SyrNitram/BLDC_Controller/3-DOCUMENTS/2-Conception/Fonctionnalités.docx

# Liste des fonctionnalités

## Pilotage du moteur

1. Pilotage des Mosfets
  a. Gestion des temps morts
  b. Gestion du courant des grilles
2. Fonctionnement 6-step
  a. Lecture des capteurs à effets Hall
  b. Mise à jour de la position du moteur
  c. Changement d’état des Mosfets
3. Asservissement de la vitesse
  a. Mesure de la vitesse
  b. Asservissement
4. Limitation du courant dans le moteur
  a. Mesure du courant
  b. Amplification du signal
  c. Filtrage
  d. Echantillonnage
  e. Asservissement
5. Asservissement de la tension
  a. Asservissement

## Communication

1. Réception de commande
  a. Décodage de la commande
  b. Mise à jour des paramètres
2. Envoie d’information sur l’état
  a. Récupération des données
  b. Génération de la trame
  c. Envoi de la trame

# Solutions techniques

## Contrôle du moteur

### Asservissement de la vitesse

Fonction à réaliser | Solution technique
Mesure de vitesse | Enregistrement de la valeur d’un compteur remis à zéro à chaque changement d’état des capteurs à effets halls
Asservissement | Calcul de la tension ciblée en fonction de la vitesse actuelle et de la vitesse de commande

### Limitation du courant

Fonction à réaliser | Solution technique
Mesure du courant | Resistance série de très faible valeur et mesure la tension à ses bornes
Amplification du signal | Amplificateur différentiel (gain à définir)
Echantillonnage | Mesure ADC à intervalles régulier
Filtrage | Filtre passe-bas (moyenneur) numérique
Asservissement | Ajustement de la valeur de tension de sortie en fonction courant maximum autorisé, du courant mesuré et de la tension ciblée

### Asservissement de la tension

Fonction à réaliser | Solution technique
Asservissement | Ajustement du rapport cyclique et du sens de rotation en fonction de la valeur de tension de sortie

Figure 1 Fonctionnement de l'asservissement en vitesse

### Pilotage des Mosfets

Fonction à réaliser | Solution technique
Gestion des temps morts | Composant intégré avec temps morts réglables
Gestion du courant des grilles | Composant intégré avec courant de contrôle des grilles réglables

### Fonctionnement 6-step

Fonction à réaliser | Solution technique
Lecture des capteurs à effets Hall | Interruption déclenchée sur changement d’état de chaque capteur
Mise à jour de la position du moteur | Incrément ou décrément d’une variable selon l’état actuel des capteurs et l’état précédent
Changement d’état des Mosfets | Table de vérité associant l’état des capteurs à effet Hall et l’état de commutation de Mosfets

# Communication

A voir en fonction du système dans lequel sera intégré la carte.
