SyrNitram/BLDC_Controller/3-DOCUMENTS/1-Gestion_projet/Synoptique.jpeg

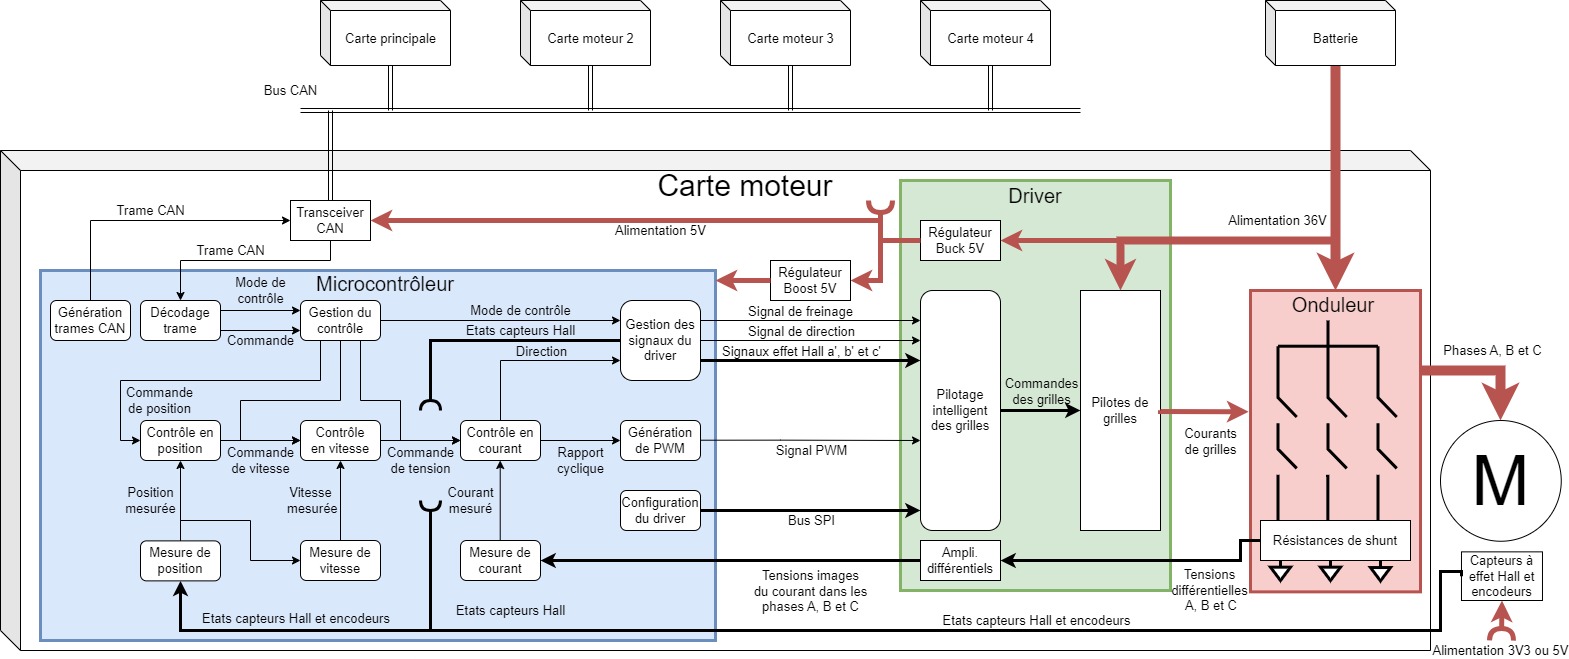
3-DOCUMENTS/1-Gestion_projet/Synoptique.jpeg
