SyrNitram/BLDC_Controller/3-DOCUMENTS/1-Gestion_projet/Bons_commandes/2023-03-23/Commande Farnell.xls

Sheet: 1 commande par mail
Fournisseur: FARNELL |  |  |  |  | Envoyez un seul fichier par mail!
Pos | I | P | Art | Désignation | Qté commandée | UA | Date Livraison | Prix unitaire | Devise | Q | Grpe | Div
10 | Z |  |  | 9758569 CAN Transceiver | 1 | PC | 30/03/2023 | 1.42 | EUR | PC | TA.01
20 | Z |  |  |  |  | PC |  |  | EUR | PC | TA.01
30 | Z |  |  |  |  | PC |  |  | EUR | PC | TA.01
40 | Z |  |  |  |  | PC |  |  | EUR | PC | TA.01
50 | Z |  |  |  |  | PC |  |  | EUR | PC | TA.01
60 | Z |  |  |  |  | PC |  |  | EUR | PC | TA.01
70 | Z |  |  |  |  | PC |  |  | EUR | PC | TA.01
80 | Z |  |  |  |  | PC |  |  | EUR | PC | TA.01
90 | Z |  |  |  |  | PC |  |  | EUR | PC | TA.01
100 | Z |  |  |  |  | PC |  |  | EUR | PC | TA.01
110 | Z |  |  |  |  | PC |  |  | EUR | PC | TA.01
120 | Z |  |  |  |  | PC |  |  | EUR | PC | TA.01
130 | Z |  |  |  |  | PC |  |  | EUR | PC | TA.01
140 | Z |  |  |  |  | PC |  |  | EUR | PC | TA.01
150 | Z |  |  |  |  | PC |  |  | EUR | PC | TA.01
160 | Z |  |  |  |  | PC |  |  | EUR | PC | TA.01
170 | Z |  |  |  |  | PC |  |  | EUR | PC | TA.01
180 | Z |  |  |  |  | PC |  |  | EUR | PC | TA.01
190 | Z |  |  | Frais de port | 1 | PC |  |  | EUR | PC | TA.01
MODE d'EMPLOI et CODE erreurs Version 19
1: indiquez le fournisseur ligne 1
2:remplissez pour chaque ligne commandée les 4 champs en rouge selon les règles suivantes:
 | Art
 |  |  | 2.1 | Ne mettez rien ici tout comme dans P: remplissez les zones rouges (et pas ailleurs)
 | Désignation
 |  |  | 2.2 | Ne dépassez pas les 40 caractères: il seront automatiquement effacés lors de la recopie
 |  |  | 2.3 | Mettre le code commande impérativement en premier suivi d'une courte description
 |  |  | 2.4 | Pour RS et Farnell : mettre le code commande RS ou Farnell (7 à 9 chiffres) (et pas la référence constructeur) suivie d'une courte description
 |  |  | 2.5 | Exemple: 125-4857 capa 1uF 0508
 | Qté commandée
 |  |  | 2.6 | C'est le nombre d'unités correspondant au prix unitaire
 |  |  | 2.7 | Attention il y a des pièges
 |  |  | 2.8 | avec RS par exemple on vous demande parfois de commander par lot de 5 par exemple
 |  |  | 2.9 | si vous commandez 1 lot : le nombre d'unité est alors 5 pour 1 lot et non 1
 | date
 |  |  | 2.10 | Pour la date: mettre la de date dans une semaine
 |  |  | 2.11 | La mettre au format JJ.MM.AAAA
 |  |  | 2.13 | Bien utiliser les points comme séparateur
 | prix unitaire
 |  |  | 2.14 | Le prix est le prix HT (sans la TVA 20%) en euros d'une unité | sauf pour les commandes au comptant ou chez un fournisseur étranger (EXP-TECH par exemple): mettez le prix TTC
 |  |  | 2.15 | arrondi au centime supérieur (0.012 euros devient 0.02!)
 |  |  | 2.16 | avec pour séparateur le point
 |  |  | 2.17 | n'utilisez pas le symbole euros d'excel
3: frais de port
 |  |  | 3.1 | ajoutez une ligne pour les frais de port
 |  |  | 3.2 | dont la désignation est "frais de port"
 |  |  | 3.3 | pas de frais de port à mettre pour RS ou Farnell
 |  |  | 3.4 | Renseignez vous pour connaître les frais de port | 9,9 euros TTC chez EXP par exemple
4: conseils complémentaires
 |  |  | 4.1 | Ne modifier que les 4 champs en rouge
 |  |  | 4.2 | Ne pas modifier le document sinon cela n'a plus aucun intérêt
 |  |  | 4.3 | Mettez les références dans le même ordre que celui de la commande
 |  |  | 4.4 | Vérifier bien sur les sites les références et les prix!
 |  |  | 4.5 | N'oubliez pas les frais de port!: ajoutez une ligne pour les mentionner
5: sauvegardez le fichier au format xls

Sheet: Feuil1
Rapport sur la compatibilité concernant commandesProjet_v19.xls
Exécuté le 29/09/2020 17:26
Les fonctionnalités répertoriées ne seront pas disponibles si vous ouvrez le classeur dans une version antérieure d’Microsoft Excel ou si vous l’enregistrez dans un format de fichier antérieur.
Perte mineure de fidélité | Nb d'occurrences | Version
Certaines cellules ou certains styles de ce classeur contiennent une mise en forme qui n'est pas prise en charge par le format de fichier sélectionné. Ces formats seront convertis au format le plus proche disponible. | 1 | Excel 97-2003
