SyrNitram/BLDC_Controller/2-SOFTWARE/BLDC_Controller/BLDC_Controller.ioc

Mcu.UserName=STM32G491CETx
PA0.GPIO_Label=SA
PA0.Signal=ADC1_IN1
PA1.GPIO_Label=SB
PA1.Signal=ADC1_IN2
PA10.GPIO_Label=HC
PA10.Signal=GPIO_Output
PA11.GPIO_Label=CAN_RX
PA11.Signal=FDCAN1_RX
PA12.GPIO_Label=CAN_TX
PA12.Signal=FDCAN1_TX
PA13.GPIO_Label=SWDIO
PA13.Signal=SYS_JTMS-SWDIO
PA14.GPIO_Label=SWCLK
PA14.Signal=SYS_JTCK-SWCLK
PA15.GPIO_Label=HALL_A
PA15.Signal=GPXTI15
PA2.GPIO_Label=SC
PA2.Signal=ADC1_IN3
PA3.GPIO_Label=VBAT
PA3.Signal=ADC1_IN4
PA5.GPIO_Label=SPI_SCK
PA5.Signal=SPI1_SCK
PA6.GPIO_Label=SPI_MISO
PA6.Signal=SPI1_MISO
PA7.GPIO_Label=SPI_MOSI
PA7.Signal=SPI1_MOSI
PA8.GPIO_Label=HA
PA8.Signal=S_TIM1_CH1
PA9.GPIO_Label=HB
PA9.Signal=GPIO_Output
PB0.GPIO_Label=SPI_NSS
PB0.Signal=GPIO_Output
PB10.GPIO_Label=nFAULT
PB10.Signal=GPXTI10
PB11.GPIO_Label=CAL
PB11.Signal=GPIO_Output
PB12.GPIO_Label=ENABLE
PB12.Signal=GPIO_Output
PB13.GPIO_Label=LA
PB13.Signal=GPIO_Output
PB14.GPIO_Label=LB
PB14.Signal=GPIO_Output
PB15.GPIO_Label=LC
PB15.Signal=GPIO_Output
PB3.GPIO_Label=SWO
PB3.Signal=SYS_JTDO-SWO
PB4.GPIO_Label=ENC_A
PB4.Signal=S_TIM3_CH1
PB5.GPIO_Label=ENC_B
PB5.Signal=S_TIM3_CH2
PB6.GPIO_Label=USART_TX
PB6.Signal=USART1_TX
PB7.GPIO_Label=USART_RX
PB7.Signal=USART1_RX
PB8-BOOT0.GPIO_Label=HALL_B
PB8-BOOT0.Signal=GPXTI8
PB9.GPIO_Label=HALL_C
PB9.Signal=GPXTI9
PF0-OSC_IN.Signal=RCC_OSC_IN
PF1-OSC_OUT.Signal=RCC_OSC_OUT
