SyrNitram/BLDC_Controller/(commit log)

2023-06-18 Organisation du projet
    Ajout des documents
    Debut du README
    [Commande Farnell.xls, Commande_Mouser.xls, commandes_vierge_format_SIFAC.xls]
2023-06-18 Ajout Liste des tâches.pdf
