SyrNitram/BLDC_Controller/(notices)

Notices in the files:
2-SOFTWARE/BLDC_Controller/Core/Inc/main.h:
Copyright (c) 2023 STMicroelectronics.
All rights reserved.
This software is licensed under terms that can be found in the LICENSE file
